zpclyn/GongXun2025/README.md

**更新日志**
|日期|发布人|内容|
| ---- | ---- | ---- |
|2026.10.27|zpclyn|根据各位的问询添加Tips并加入致谢|

</br>

# GongXun2025
**2025年工训赛智能物流河北省省冠开源**

PS：技术报告是直接Git推送的，.md文件直接在Github上查看可能有排版错误，建议使用Typora查看或者直接查看PDF文件。

---
### Tips:
1. 截至2026.10.27该智能物流小车在笔者见过的全部设计中依旧是最快的(**2分13秒**)成绩最高的(满分全一环)，与此同时成本也是最低的一批，笔者对此感到自豪。
2. 笔者全面开源的本意是新同学可以更快的上手，同时也可以给老队员提供一定的思路，推动整个智能物流圈子的发展，不过还是建议大家不要照搬全抄，这个设计还是有很多优化空间的。
3. 目前硬件部分的开源还做不到，涉及潘航同学的成果，除非潘航同学同意否则将无法提供硬件设计，不过笔者可以提供部分硬件设计方向，只是想要硬件设计的同学就不用加笔者联系方式了，真的提供不了。
4. 后面为了大家查看方便，或许会迁移Gitee。
5. **本开源未授权任何人借此商用，禁止任何人在未授权的情况下在任何平台售卖！**

---
## 致谢
该智能物流小车机械部分由**张展赫**同学为主笔者优化共同完成（前面写文档的时候真的真的忘记了，十分抱歉`(*>﹏<*)′），硬件和视觉部分由**潘航**同学([https://gitee.com/laladuduqq](https://gitee.com/laladuduqq))独立完成，控制部分由笔者独自完成。

然后感谢**刘浩**同学在第十届(2024)提供的大量大量帮助，感谢张坤同学和黄奕翀同学在第十一届(2025)提供的部分调试帮助。

其次感谢各位借鉴本开源的同学们，感谢各位对我的信任。据我所知今年河北赛区有多个队伍通过复刻本开源拿到省特等奖，笔者对此祝贺并感到欣喜。

最后提一嘴，设计没有高低适合自己适合比赛的才是最好的，不要无脑贬低，笔者不否认该设计从机械到控制并不绝对高级，但该设计简单适合比赛就是好设计，笔者接受合理的批评建议，但一边抄开源一边贬低就有点离谱了，最后希望各位使用开源分享在公共平台时可以提及本开源十分感谢`(*>﹏<*)′
