zpclyn/GongXun2025/IMAGE/屏幕截图 2025-11-13 145449.png

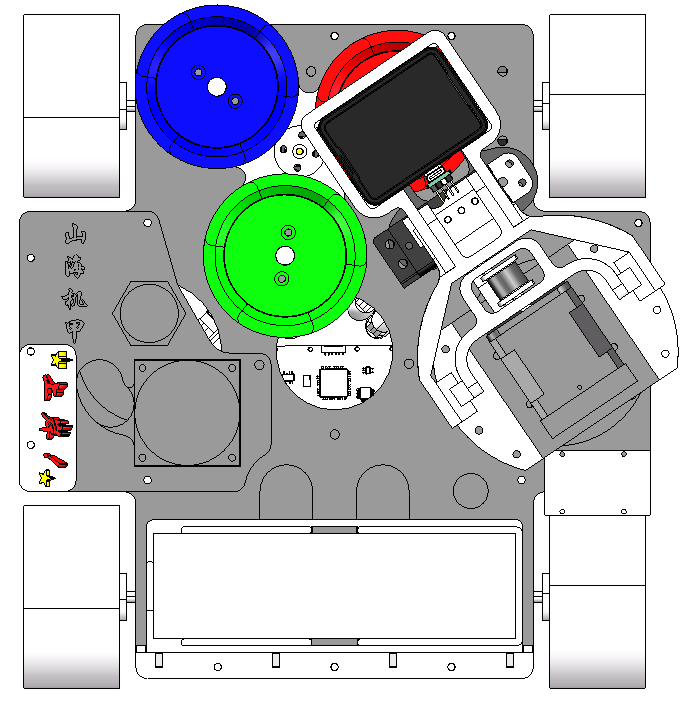
IMAGE/屏幕截图 2025-11-13 145449.png
