zpclyn/GongXun2025/机械/云台底板.SLDPRT

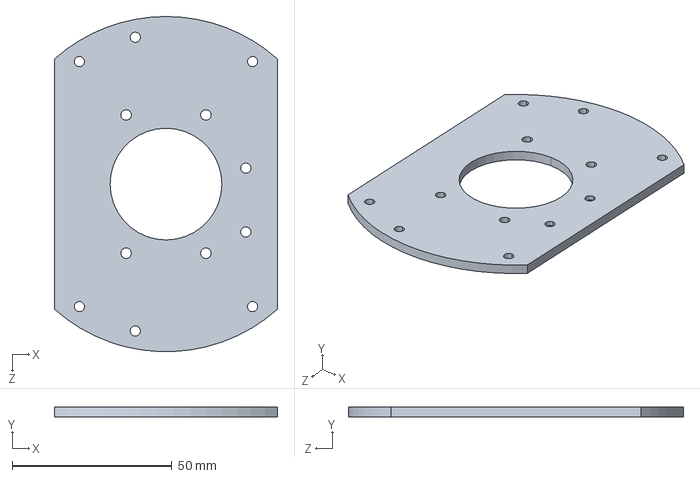
[picture p16: CAD file, 2025-11-13]
机械/云台底板.SLDPRT
70.0 x 3.00 x 104.9 mm
