zpclyn/GongXun2025/机械/云台轴承外挡边下板.SLDPRT

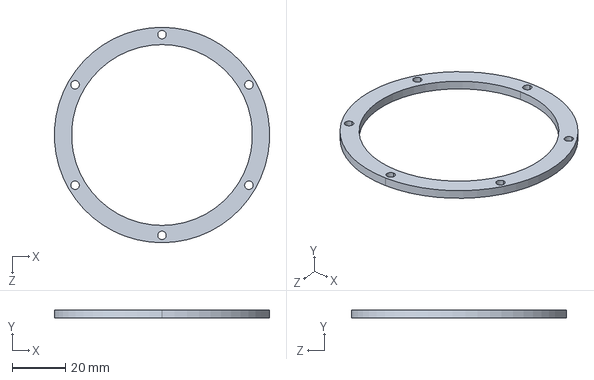
[picture p17: CAD file, 2025-11-13]
机械/云台轴承外挡边下板.SLDPRT
80.9 x 3.00 x 81.0 mm
