zpclyn/GongXun2025/机械/云台夹爪链接架.SLDPRT

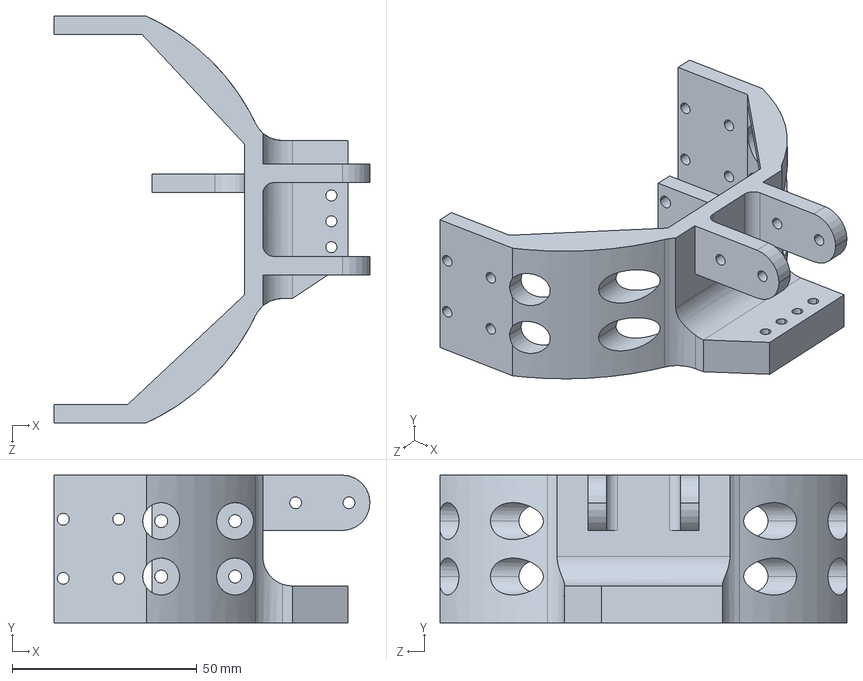
[picture p18: CAD file, 2025-11-13]
机械/云台夹爪链接架.SLDPRT
85.5 x 40.0 x 110.0 mm
