zpclyn/GongXun2025/机械/云台导轨连接块.SLDPRT

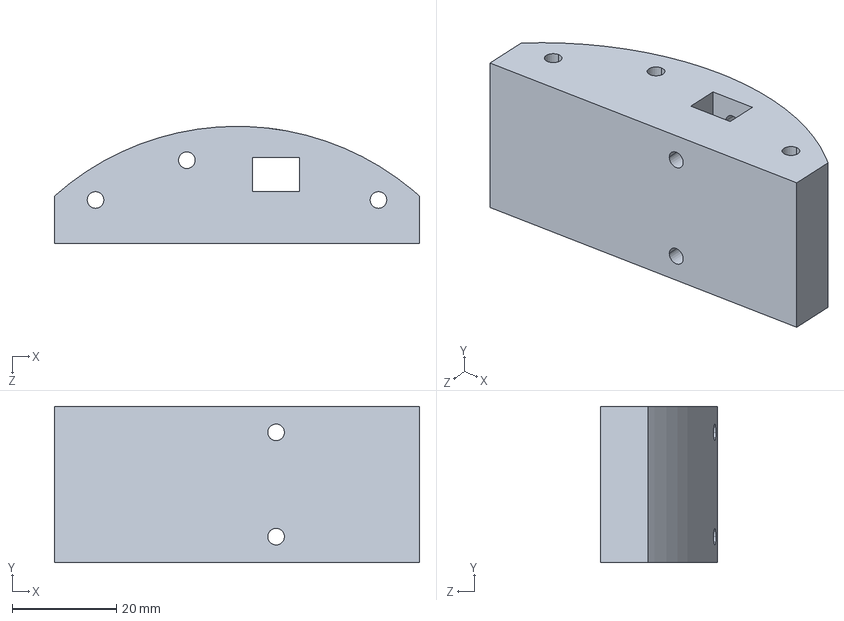
[picture p19: CAD file, 2025-11-13]
机械/云台导轨连接块.SLDPRT
70.0 x 30.0 x 22.5 mm
