zpclyn/GongXun2025/机械/导轨滑块.SLDPRT

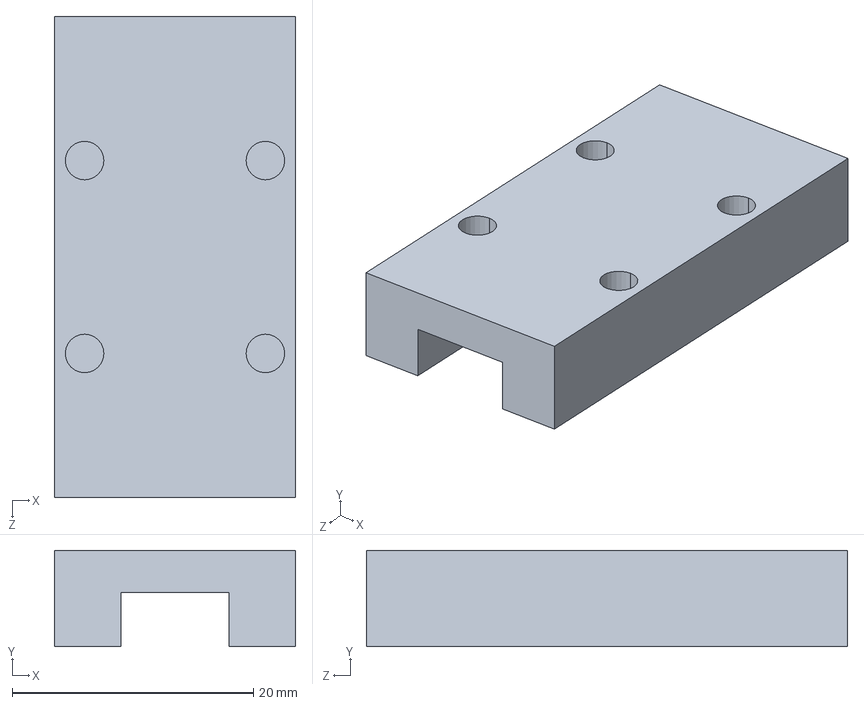
[picture p20: CAD file, 2025-11-13]
机械/导轨滑块.SLDPRT
20.0 x 8.00 x 39.9 mm
