zpclyn/GongXun2025/机械/云台轴承外挡边垫块.SLDPRT

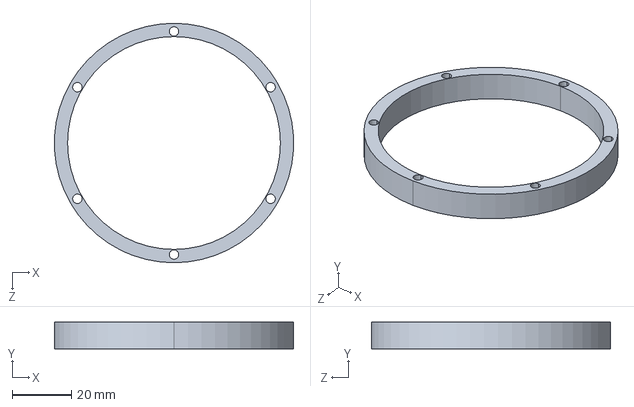
[picture p21: CAD file, 2025-11-13]
机械/云台轴承外挡边垫块.SLDPRT
80.9 x 9.00 x 81.0 mm
