zpclyn/GongXun2025/机械/推力轴承.SLDPRT

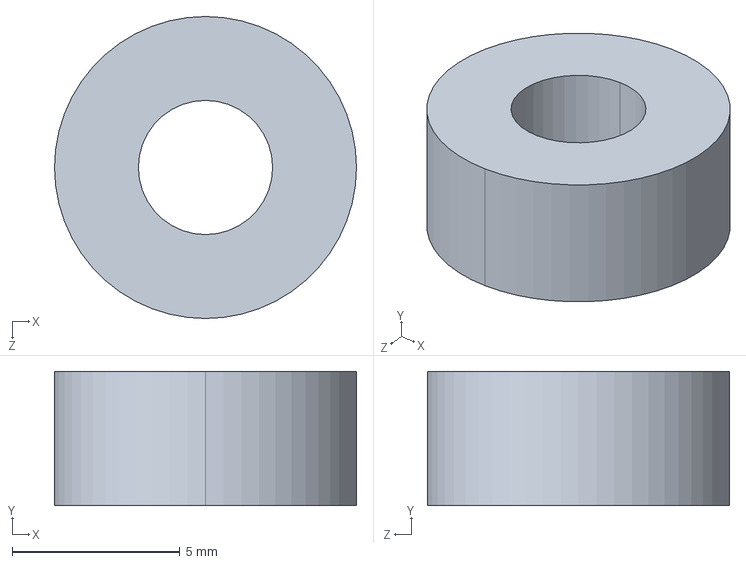
[picture p22: CAD file, 2025-11-13]
机械/推力轴承.SLDPRT
9.00 x 4.00 x 9.00 mm
