zpclyn/GongXun2025/机械/夹爪下层2.SLDPRT

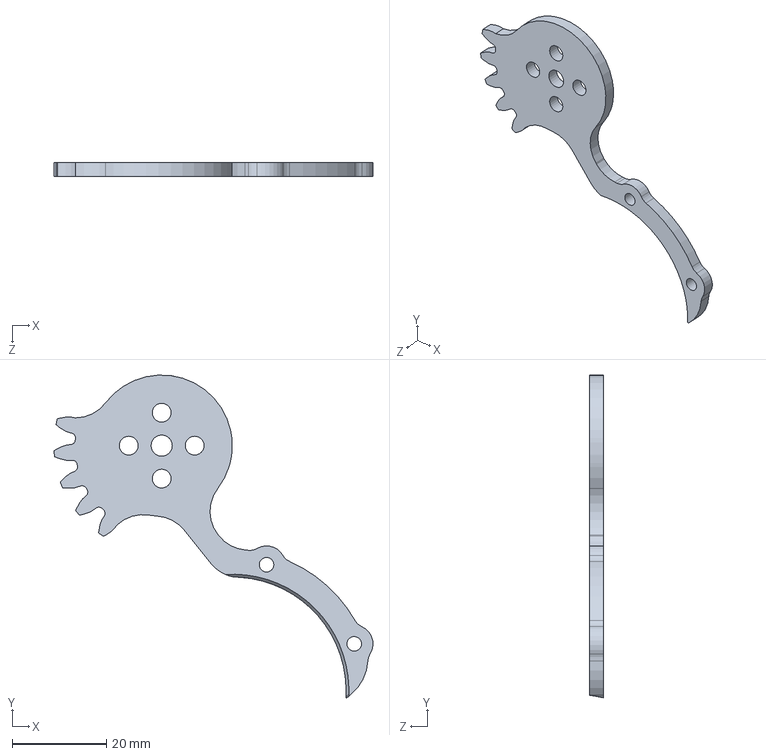
[picture p23: CAD file, 2025-11-13]
机械/夹爪下层2.SLDPRT
67.8 x 68.6 x 3.00 mm
