zpclyn/GongXun2025/机械/电池盒.SLDPRT

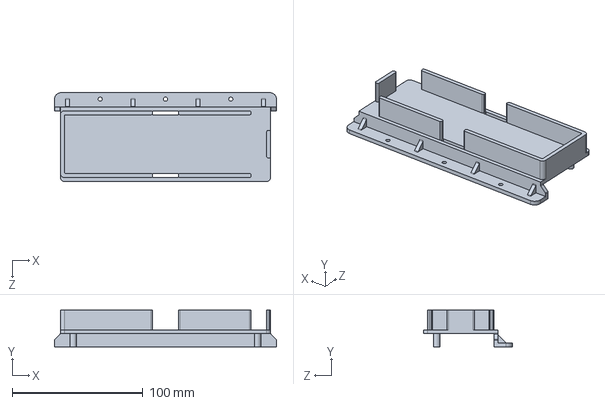
[picture p24: CAD file, 2025-11-13]
机械/电池盒.SLDPRT
170.0 x 28.0 x 68.0 mm
