zpclyn/GongXun2025/机械/上底板.SLDPRT

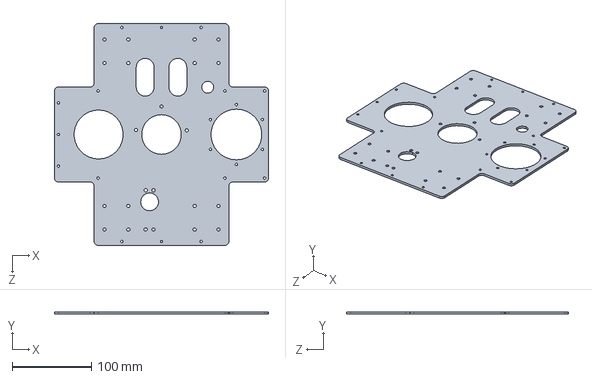
[picture p25: CAD file, 2025-11-13]
机械/上底板.SLDPRT
270.0 x 3.00 x 280.0 mm
