zpclyn/GongXun2025/机械/夹爪舵机架.SLDPRT

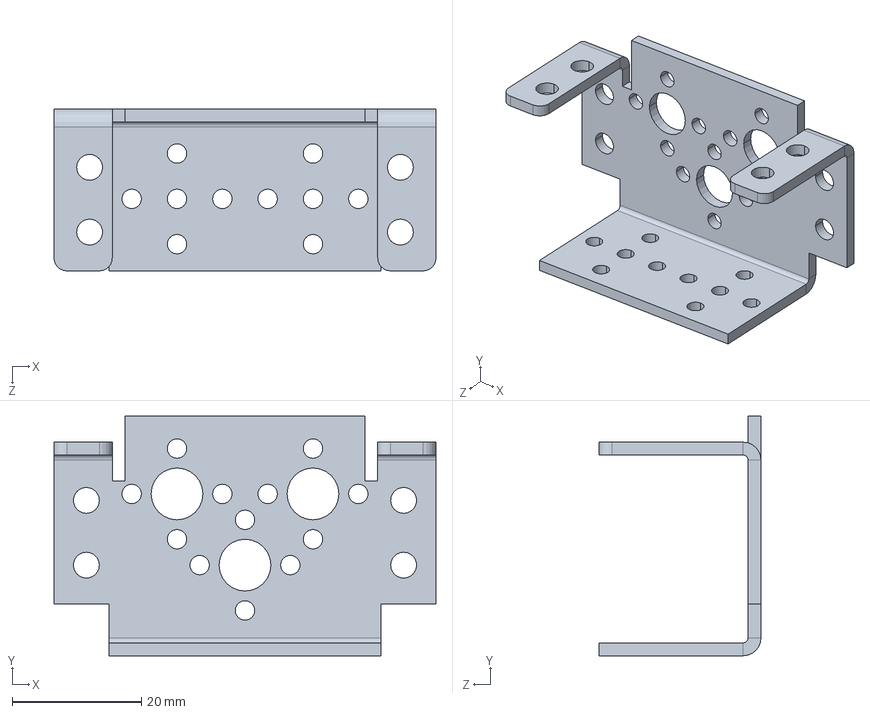
[picture p26: CAD file, 2025-11-13]
机械/夹爪舵机架.SLDPRT
59.0 x 37.0 x 25.0 mm
