zpclyn/GongXun2025/机械/六角不锈钢柱M3x45.SLDPRT

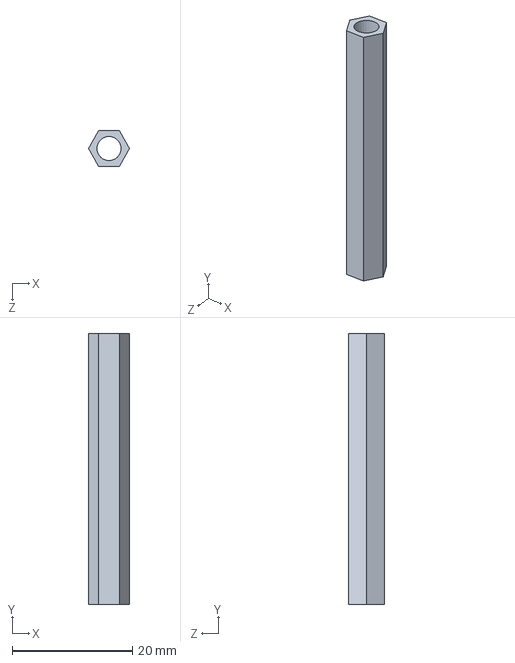
[picture p27: CAD file, 2025-11-13]
机械/六角不锈钢柱M3x45.SLDPRT
6.80 x 45.0 x 6.00 mm
