zpclyn/GongXun2025/机械/铝柱M4-D6-6.SLDPRT

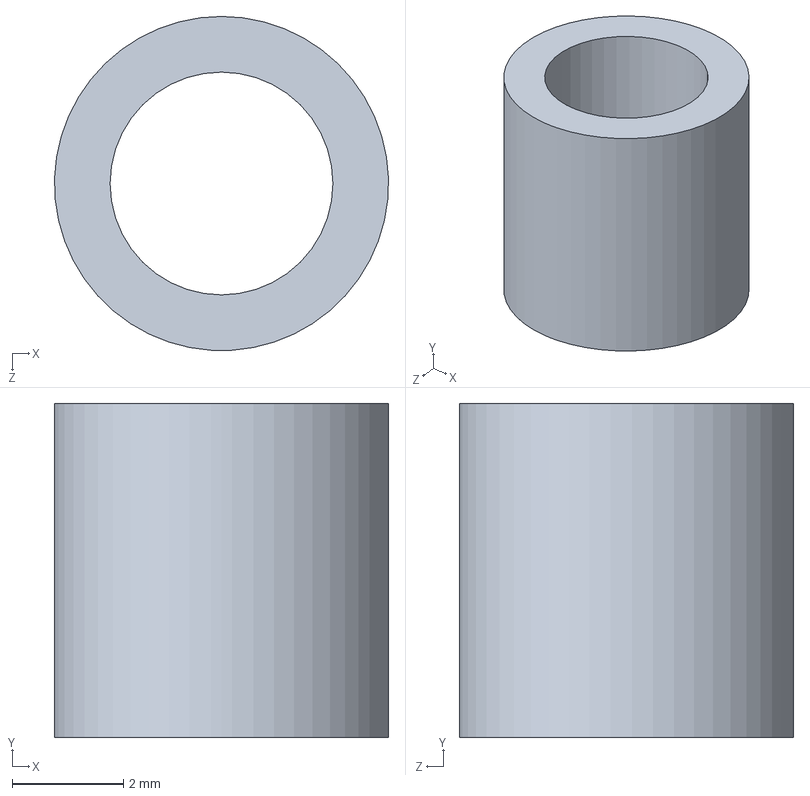
[picture p28: CAD file, 2025-11-13]
机械/铝柱M4-D6-6.SLDPRT
6.00 x 6.00 x 6.00 mm
