zpclyn/GongXun2025/机械/夹爪连接垫块.SLDPRT

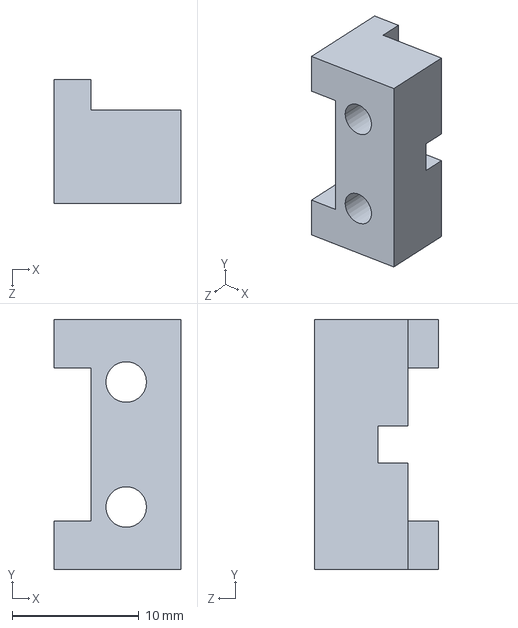
[picture p29: CAD file, 2025-11-13]
机械/夹爪连接垫块.SLDPRT
9.99 x 19.7 x 9.80 mm
