zpclyn/GongXun2025/机械/连接块6x6x40.SLDPRT

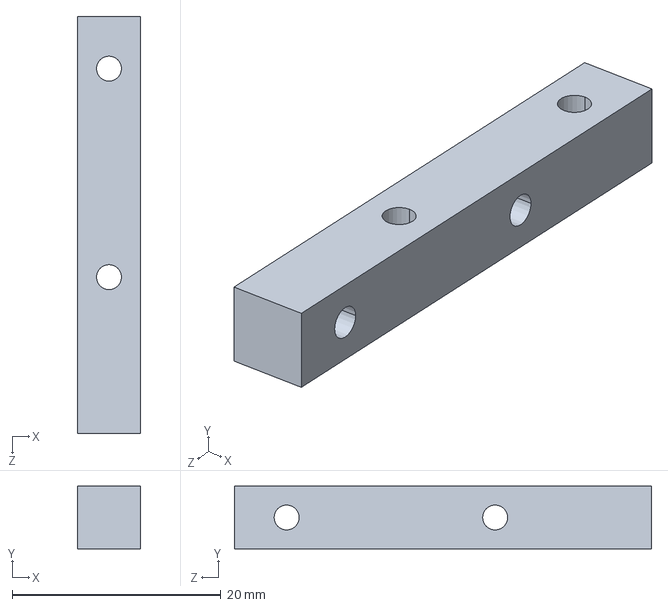
[picture p30: CAD file, 2025-11-13]
机械/连接块6x6x40.SLDPRT
6.00 x 6.00 x 40.0 mm
