zpclyn/GongXun2025/机械/舵盘.SLDPRT

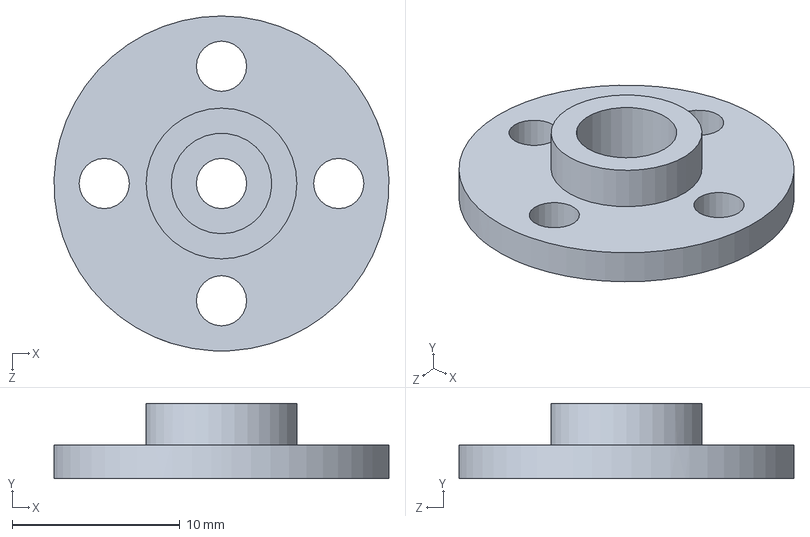
[picture p31: CAD file, 2025-11-13]
机械/舵盘.SLDPRT
20.0 x 4.50 x 20.0 mm
