zpclyn/GongXun2025/机械/摄像头固定件.SLDPRT

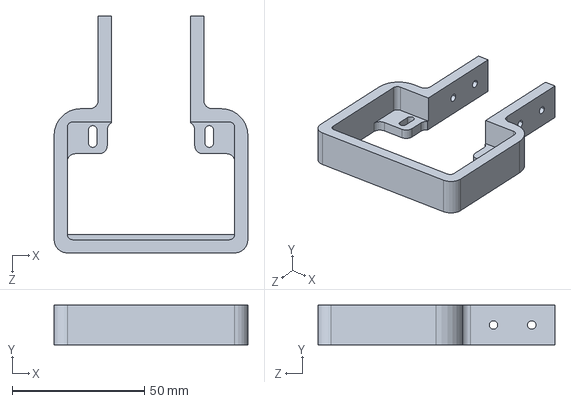
[picture p32: CAD file, 2025-11-13]
机械/摄像头固定件.SLDPRT
73.2 x 15.0 x 89.5 mm
