zpclyn/GongXun2025/机械/HWT101CT.SLDPRT

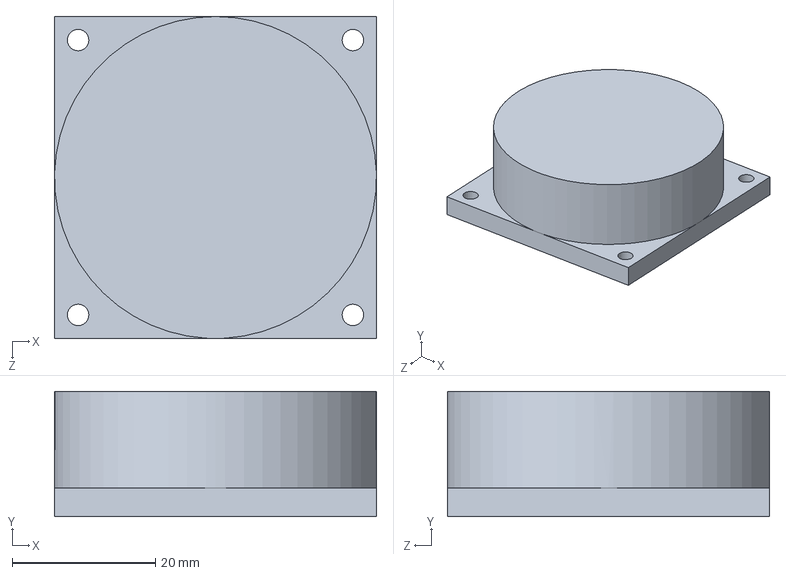
[picture p33: CAD file, 2025-11-13]
机械/HWT101CT.SLDPRT
45.0 x 17.5 x 45.0 mm
