zpclyn/GongXun2025/机械/电池.SLDPRT

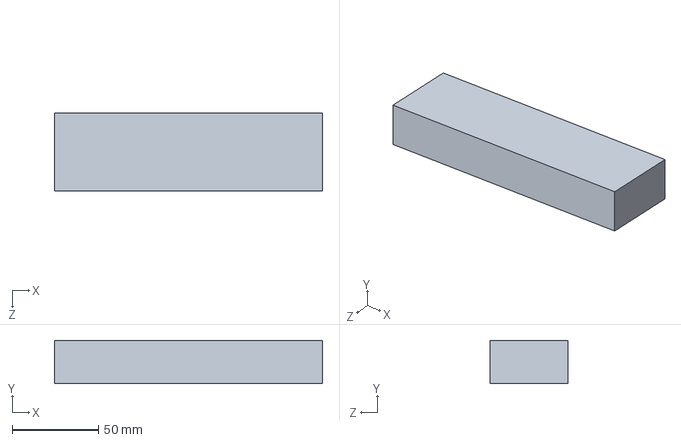
[picture p35: CAD file, 2025-11-13]
机械/电池.SLDPRT
155.0 x 25.0 x 45.0 mm
