zpclyn/GongXun2025/机械/初赛夹爪上层1-玻纤.SLDPRT

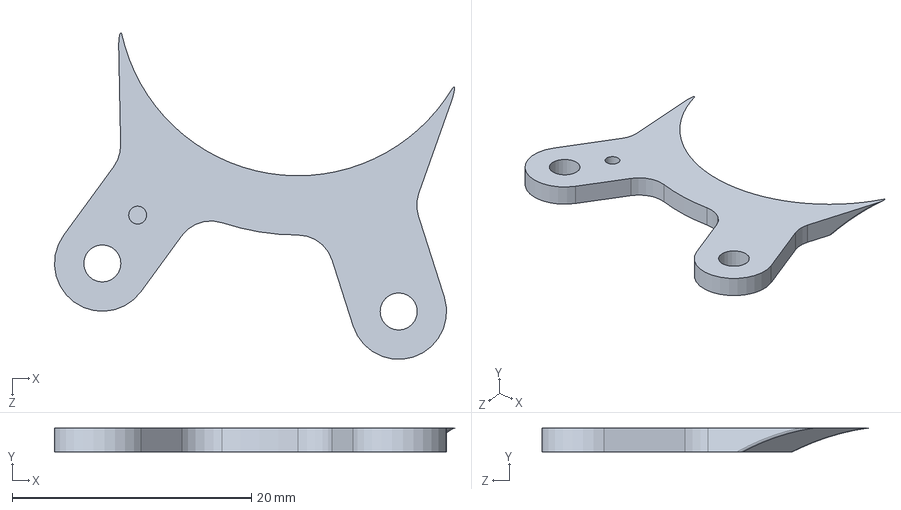
[picture p36: CAD file, 2025-11-13]
机械/初赛夹爪上层1-玻纤.SLDPRT
33.4 x 2.00 x 27.3 mm
