zpclyn/GongXun2025/机械/初赛物料.SLDPRT

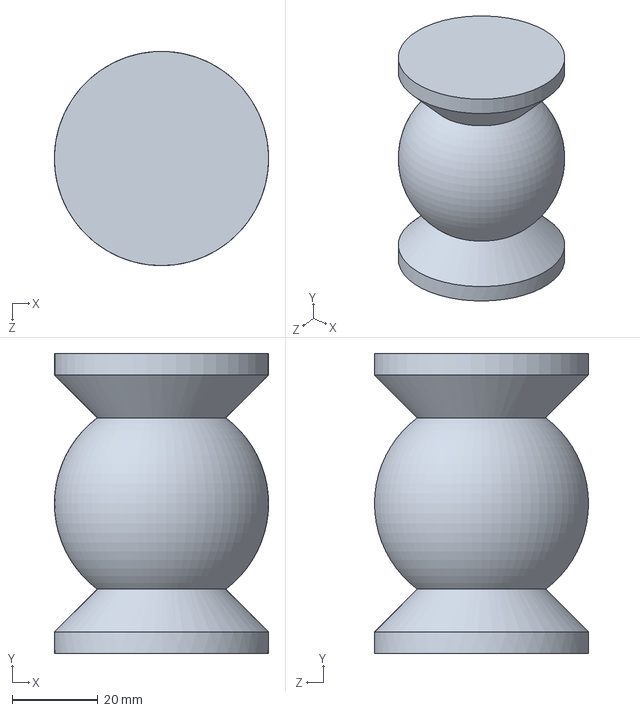
[picture p37: CAD file, 2025-11-13]
机械/初赛物料.SLDPRT
50.0 x 70.0 x 50.0 mm
