zpclyn/GongXun2025/机械/导轨250mm.SLDPRT

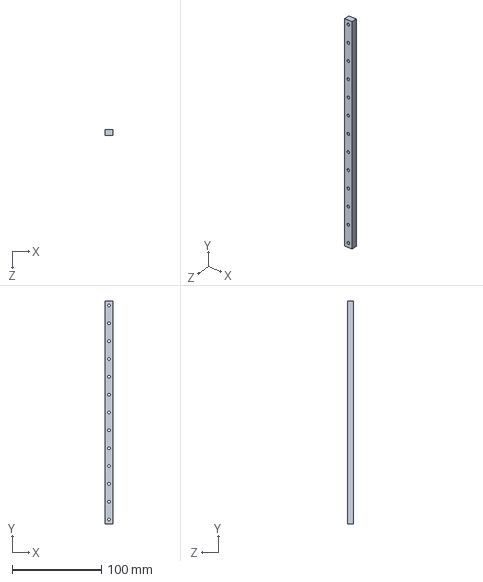
[picture p38: CAD file, 2025-11-13]
机械/导轨250mm.SLDPRT
9.00 x 250.0 x 6.50 mm
