zpclyn/GongXun2025/机械/上岸.SLDPRT

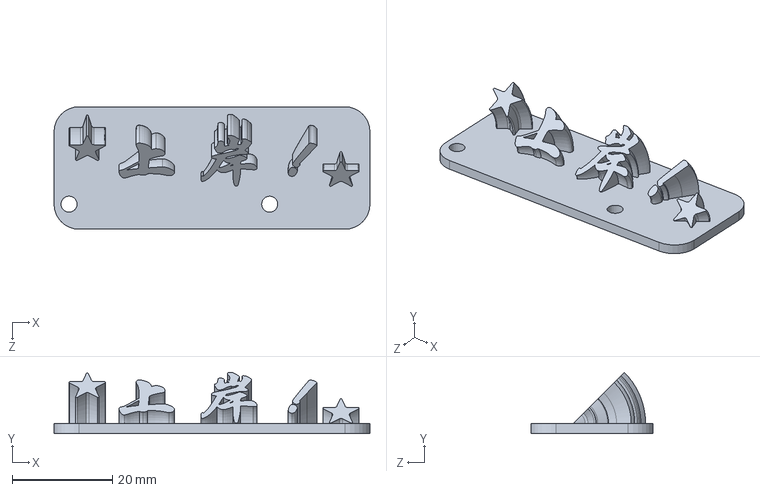
[picture p39: CAD file, 2025-11-13]
机械/上岸.SLDPRT
63.0 x 12.2 x 24.4 mm
