zpclyn/GongXun2025/机械/六角不锈钢柱M3x60.SLDPRT

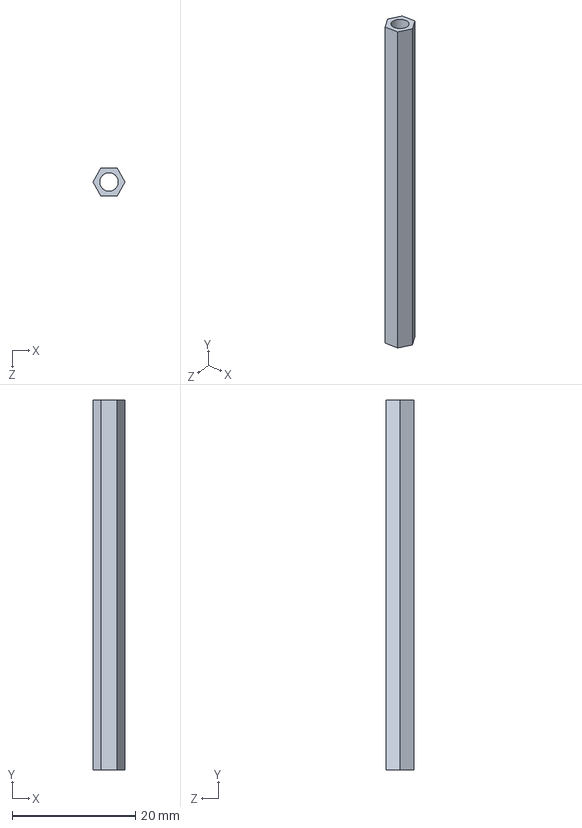
[picture p40: CAD file, 2025-11-13]
机械/六角不锈钢柱M3x60.SLDPRT
5.20 x 60.0 x 4.60 mm
