zpclyn/GongXun2025/机械/陀螺仪及按钮固定板.SLDPRT

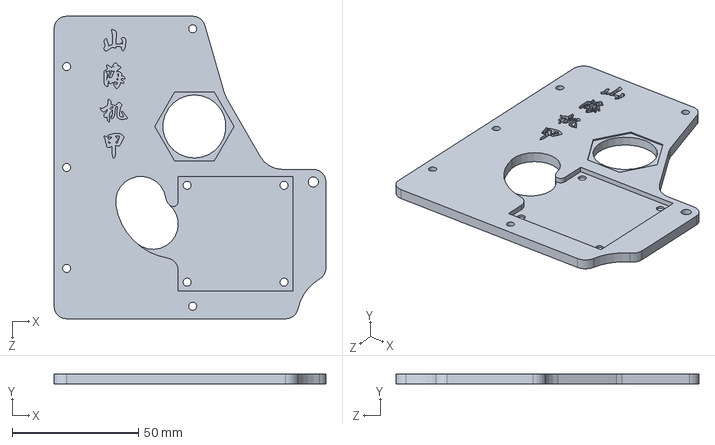
[picture p41: CAD file, 2025-11-13]
机械/陀螺仪及按钮固定板.SLDPRT
107.8 x 4.00 x 120.0 mm
