zpclyn/GongXun2025/机械/同步带压板.SLDPRT

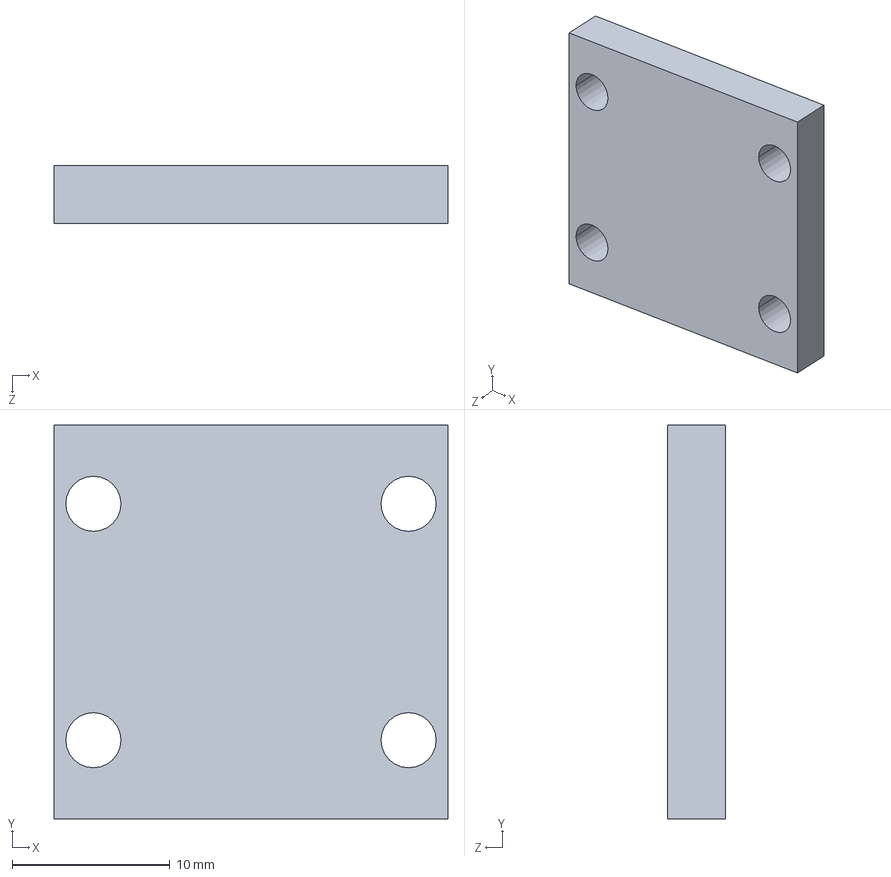
[picture p42: CAD file, 2025-11-13]
机械/同步带压板.SLDPRT
25.0 x 25.0 x 3.70 mm
