zpclyn/GongXun2025/机械/同步带轮上连接块.SLDPRT

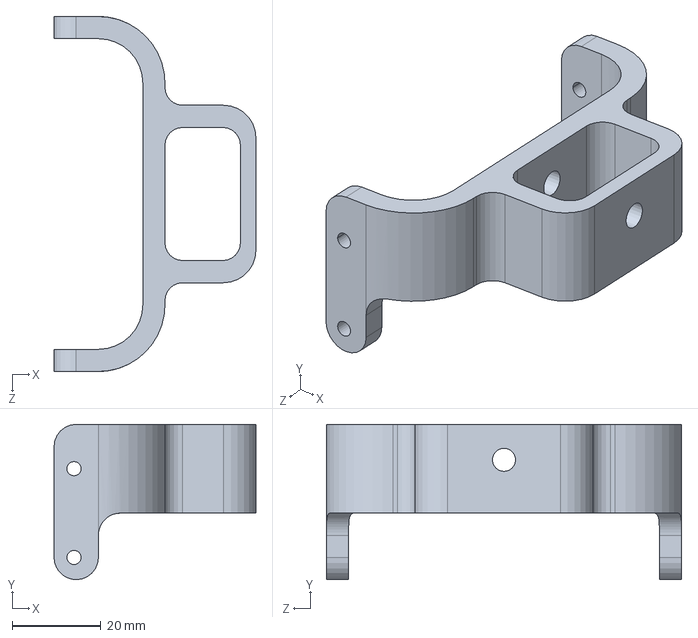
[picture p43: CAD file, 2025-11-13]
机械/同步带轮上连接块.SLDPRT
45.5 x 35.0 x 80.0 mm
