zpclyn/GongXun2025/机械/夹爪连接板.SLDPRT

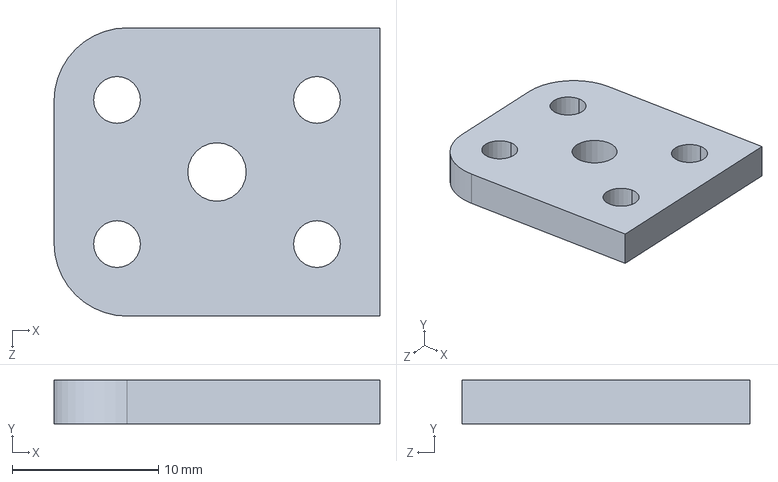
[picture p44: CAD file, 2025-11-13]
机械/夹爪连接板.SLDPRT
22.3 x 3.00 x 19.7 mm
