zpclyn/GongXun2025/机械/初赛物料座.SLDPRT

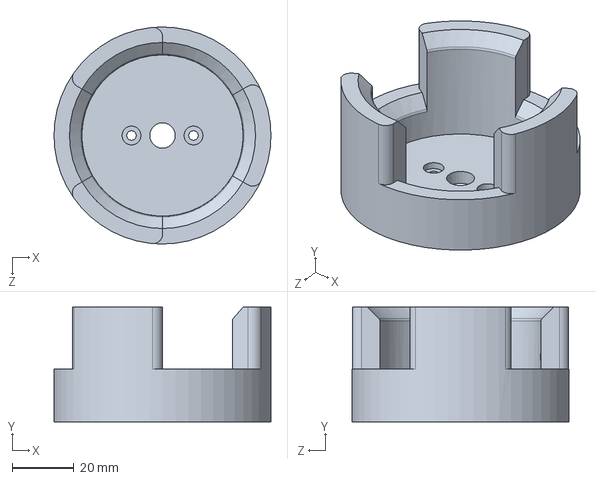
[picture p45: CAD file, 2025-11-13]
机械/初赛物料座.SLDPRT
70.0 x 37.0 x 70.0 mm
