zpclyn/GongXun2025/机械/决赛夹爪上层-CNC.SLDPRT

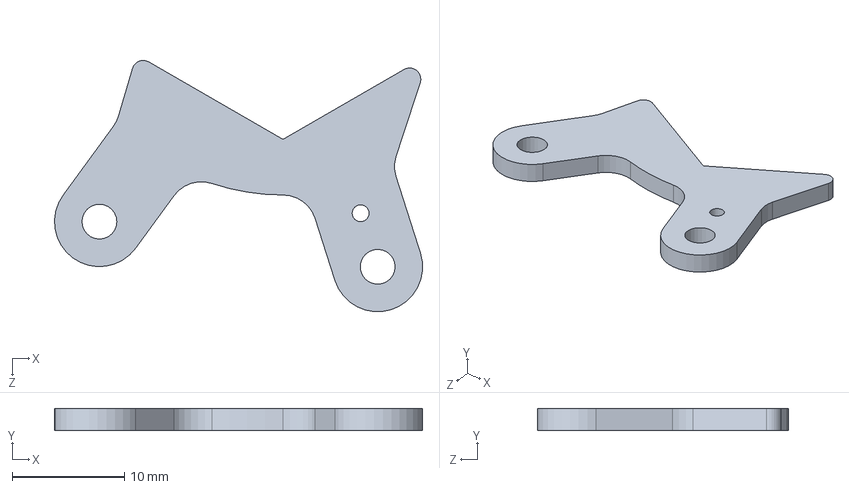
[picture p46: CAD file, 2025-11-13]
机械/决赛夹爪上层-CNC.SLDPRT
32.7 x 2.00 x 22.3 mm
