zpclyn/GongXun2025/机械/云台步进连接板.SLDPRT

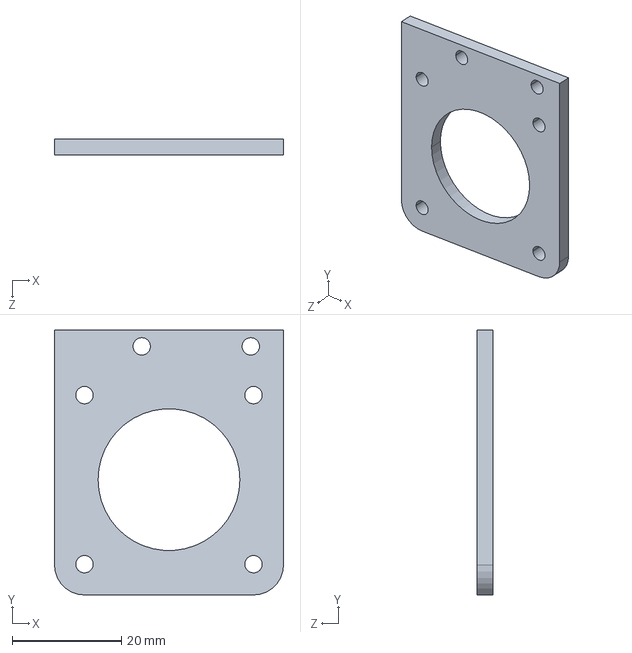
[picture p47: CAD file, 2025-11-13]
机械/云台步进连接板.SLDPRT
42.0 x 48.6 x 3.00 mm
