zpclyn/GongXun2025/机械/云台轴承内挡边下板.SLDPRT

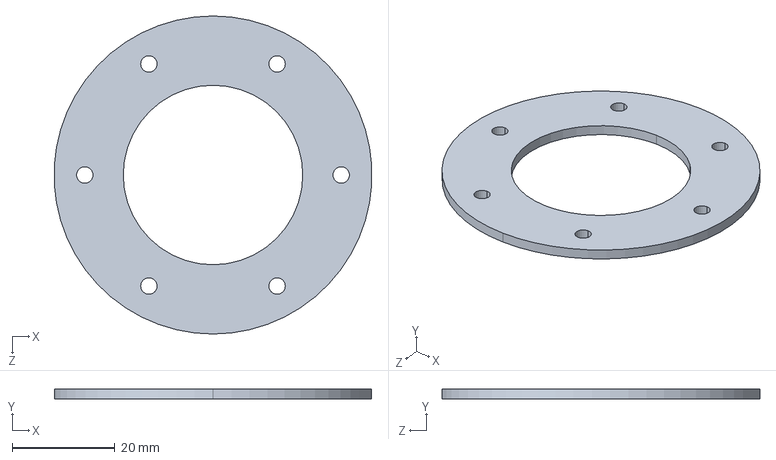
[picture p48: CAD file, 2025-11-13]
机械/云台轴承内挡边下板.SLDPRT
61.9 x 2.00 x 62.0 mm
