zpclyn/GongXun2025/机械/连接.SLDPRT

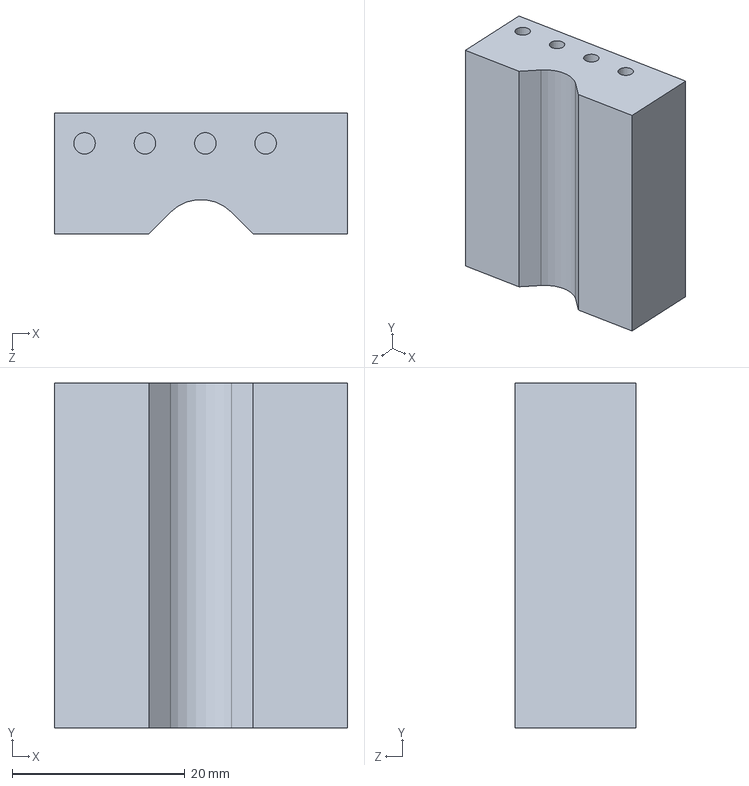
[picture p49: CAD file, 2025-11-13]
机械/连接.SLDPRT
34.0 x 40.0 x 14.0 mm
