zpclyn/GongXun2025/机械/云台轴承外挡边上板.SLDPRT

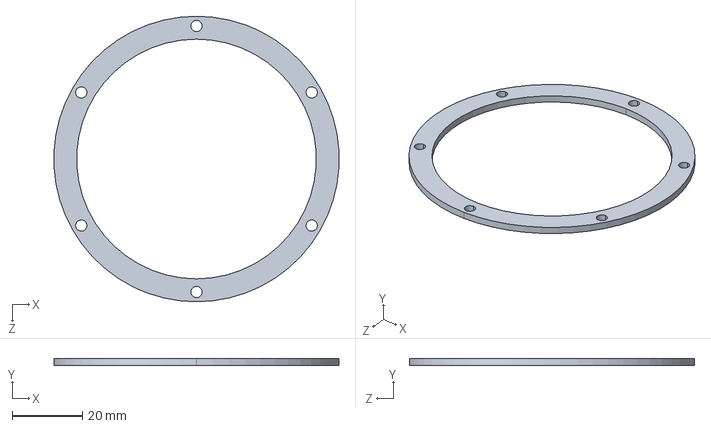
[picture p50: CAD file, 2025-11-13]
机械/云台轴承外挡边上板.SLDPRT
80.9 x 2.00 x 81.0 mm
