zpclyn/GongXun2025/机械/云台轴承内挡边.SLDPRT

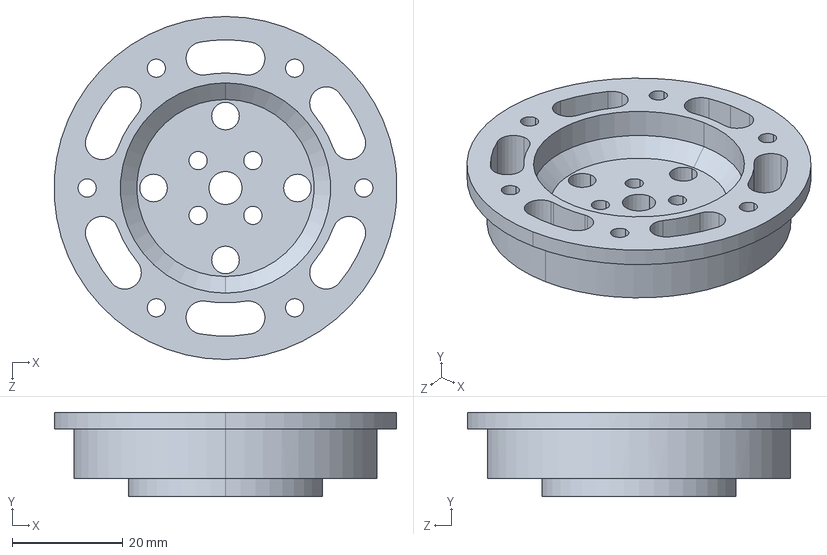
[picture p51: CAD file, 2025-11-13]
机械/云台轴承内挡边.SLDPRT
61.9 x 15.2 x 62.0 mm
