zpclyn/GongXun2025/机械/同步带.SLDPRT

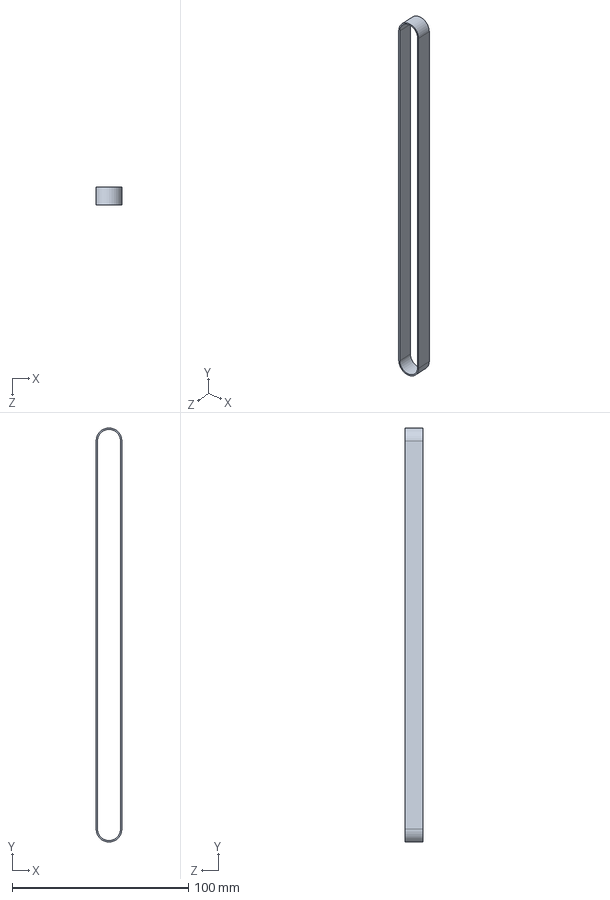
[picture p52: CAD file, 2025-11-13]
机械/同步带.SLDPRT
14.6 x 234.6 x 10.0 mm
