zpclyn/GongXun2025/机械/决赛物料顶层.SLDPRT

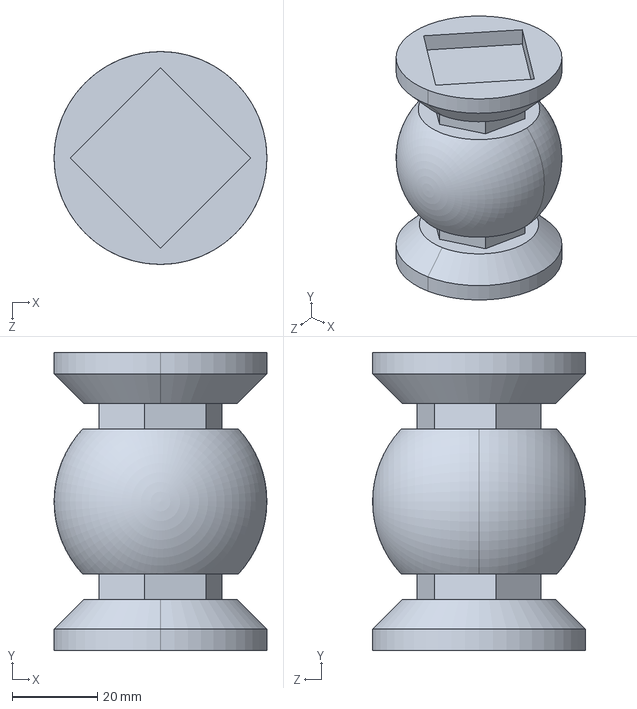
[picture p53: CAD file, 2025-11-13]
机械/决赛物料顶层.SLDPRT
50.0 x 70.0 x 50.0 mm
