zpclyn/GongXun2025/机械/42步进.SLDPRT

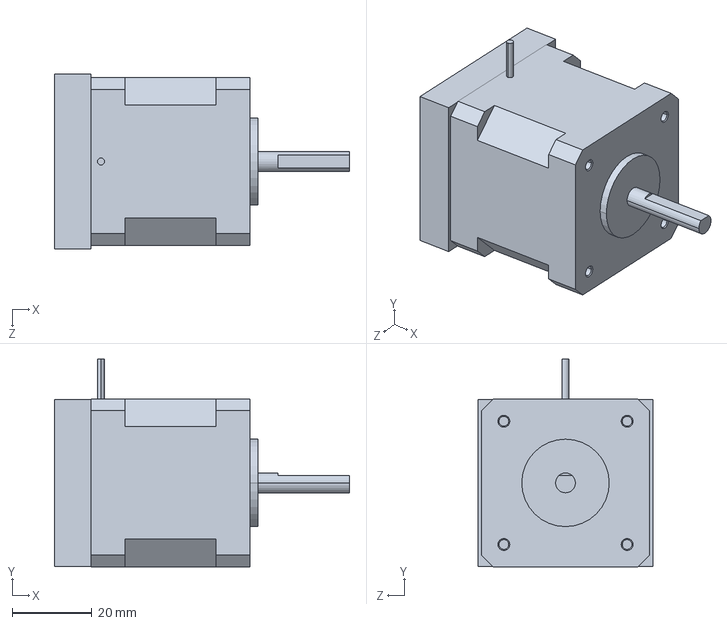
[picture p54: CAD file, 2025-11-13]
机械/42步进.SLDPRT
74.2 x 52.3 x 43.9 mm
