zpclyn/GongXun2025/机械/尼龙螺柱M3-D5-11.SLDPRT

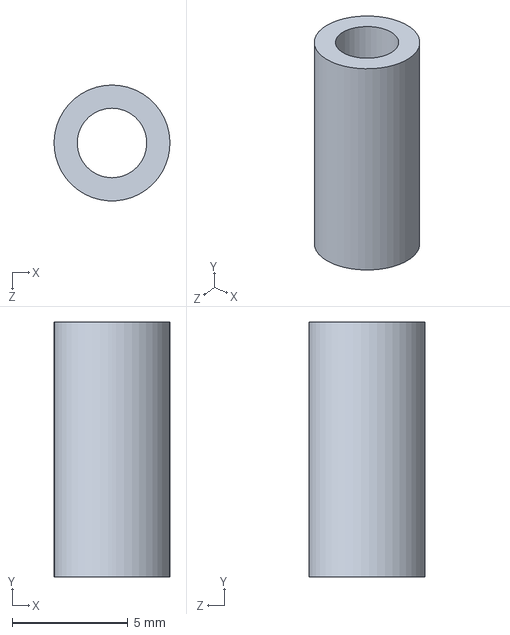
[picture p55: CAD file, 2025-11-13]
机械/尼龙螺柱M3-D5-11.SLDPRT
5.00 x 11.0 x 5.00 mm
