zpclyn/GongXun2025/机械/下底板.SLDPRT

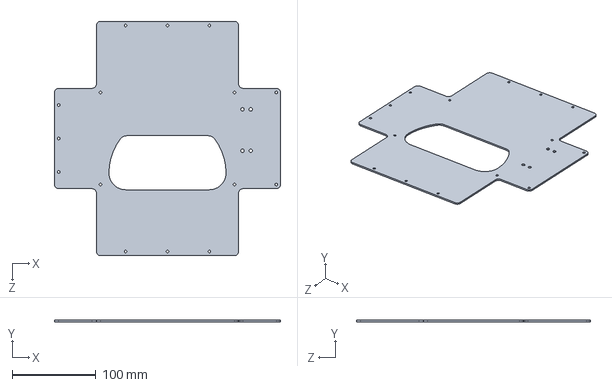
[picture p56: CAD file, 2025-11-13]
机械/下底板.SLDPRT
270.0 x 2.00 x 280.0 mm
