zpclyn/GongXun2025/机械/铝柱M4-D6-10.SLDPRT

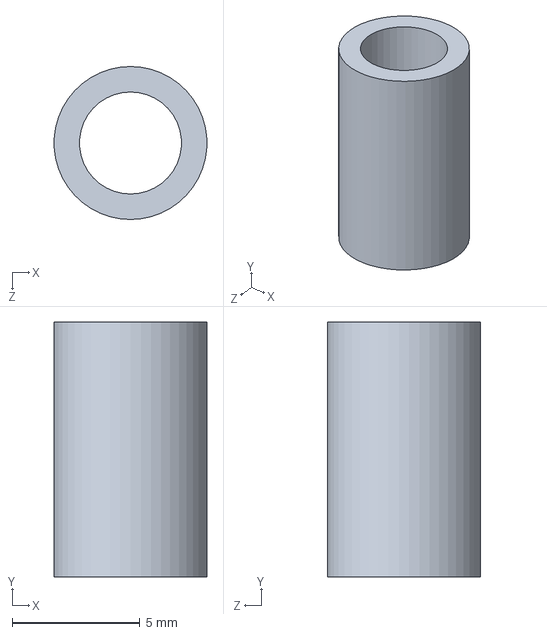
[picture p58: CAD file, 2025-11-13]
机械/铝柱M4-D6-10.SLDPRT
5.99 x 10.0 x 6.00 mm
