zpclyn/GongXun2025/机械/转盘.SLDPRT

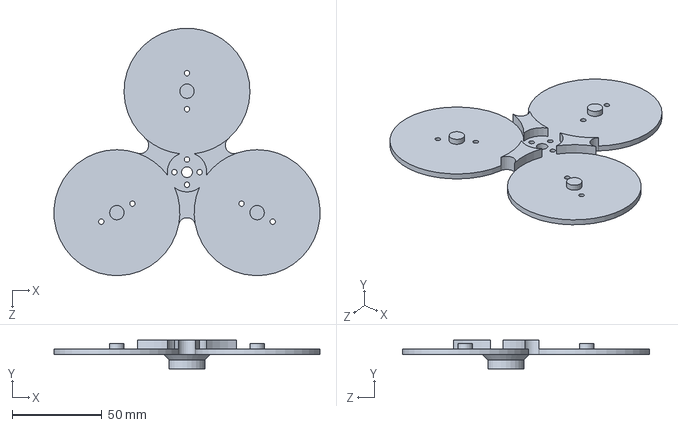
[picture p59: CAD file, 2025-11-13]
机械/转盘.SLDPRT
147.8 x 16.0 x 137.3 mm
