zpclyn/GongXun2025/机械/云台轴承.SLDPRT

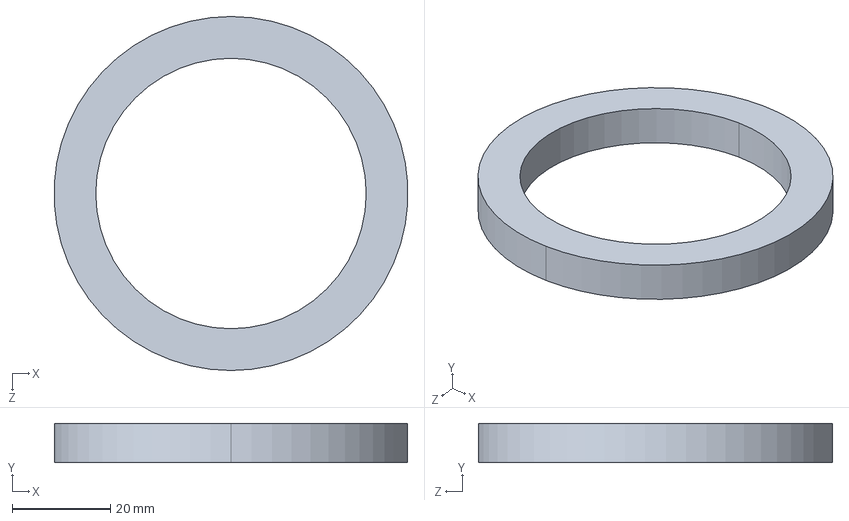
[picture p60: CAD file, 2025-11-13]
机械/云台轴承.SLDPRT
71.9 x 8.00 x 72.0 mm
