zpclyn/GongXun2025/机械/舵机.SLDPRT

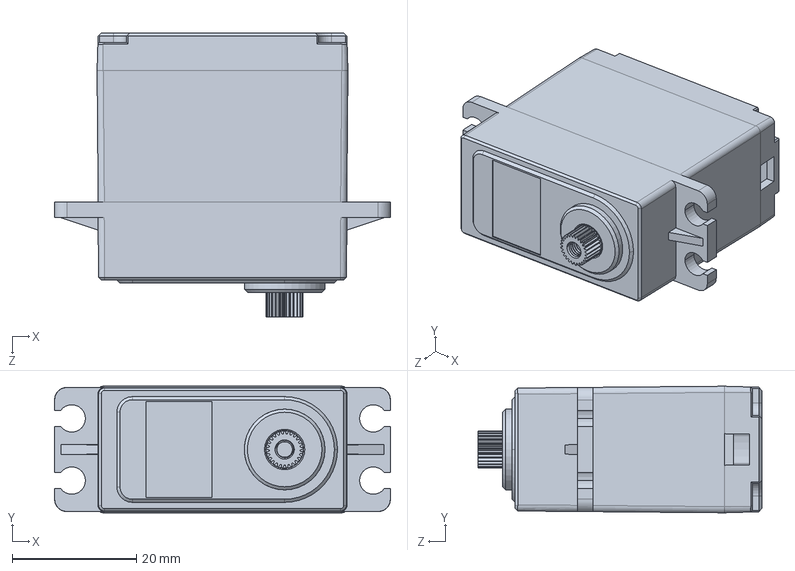
[picture p61: CAD file, 2025-11-13]
机械/舵机.SLDPRT
54.1 x 20.4 x 45.7 mm
