zpclyn/GongXun2025/机械/同步带轮.SLDPRT

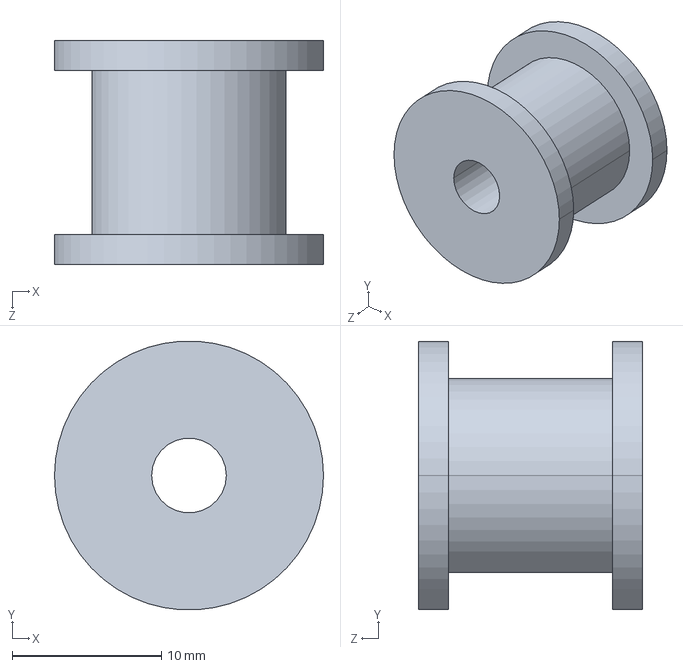
[picture p62: CAD file, 2025-11-13]
机械/同步带轮.SLDPRT
18.0 x 18.0 x 15.0 mm
