zpclyn/GongXun2025/机械/GM865二维码模块.SLDPRT

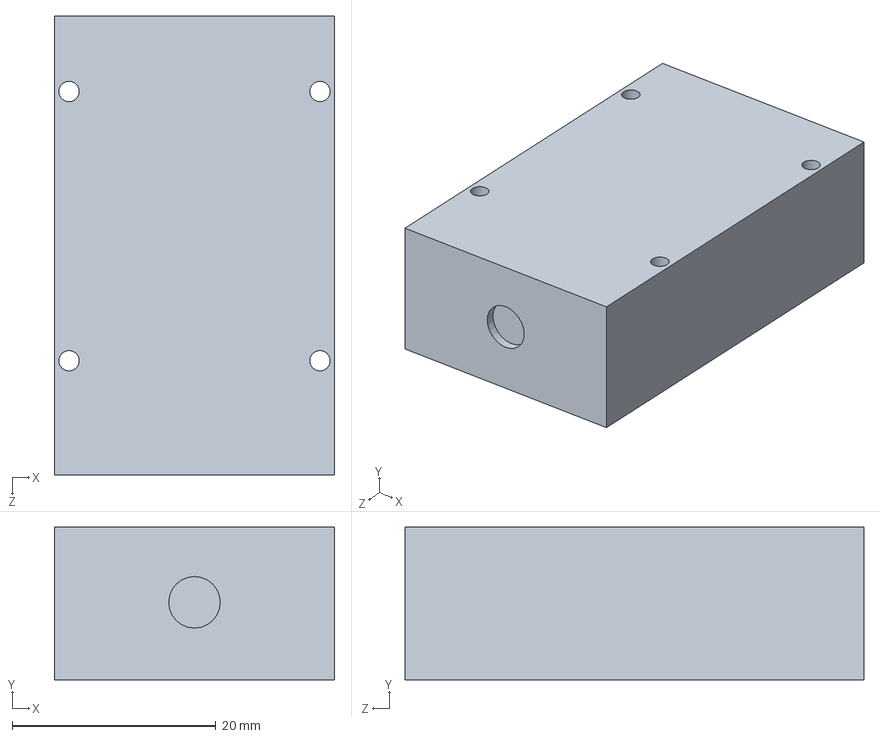
[picture p63: CAD file, 2025-11-13]
机械/GM865二维码模块.SLDPRT
27.5 x 15.0 x 45.0 mm
