zpclyn/GongXun2025/机械/夹爪下层1.SLDPRT

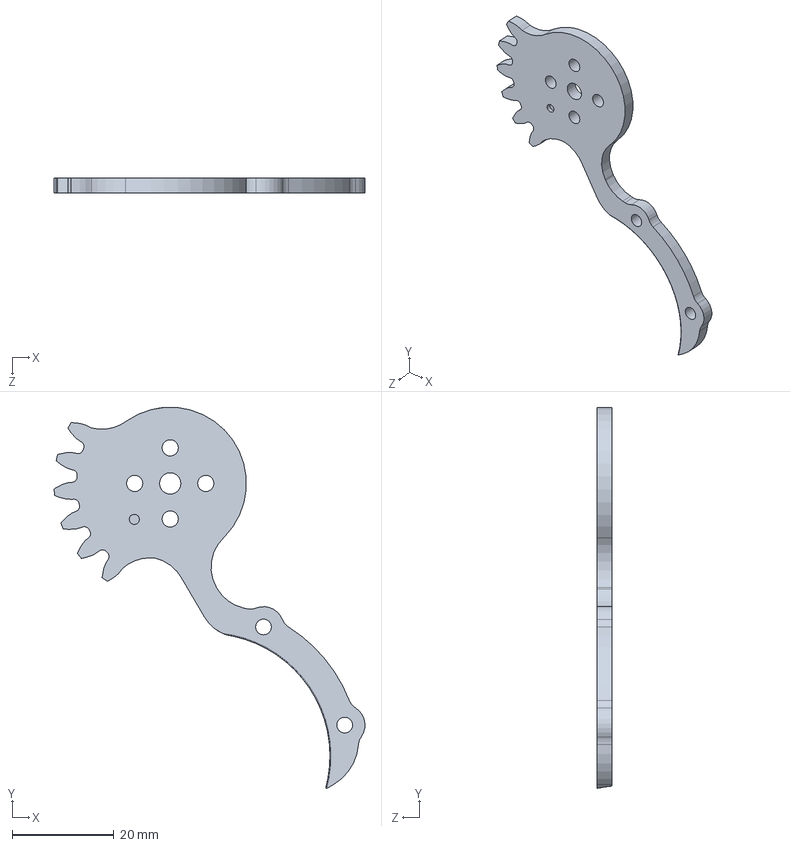
[picture p64: CAD file, 2025-11-13]
机械/夹爪下层1.SLDPRT
61.2 x 75.0 x 3.00 mm
