zpclyn/GongXun2025/机械/轮组.SLDASM

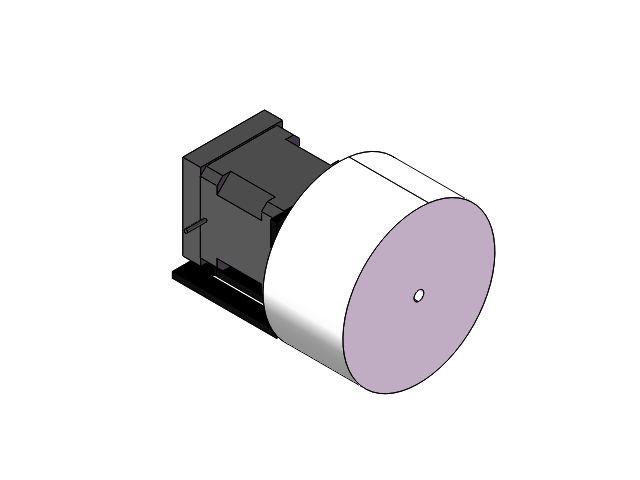
[picture p65: CAD file, 2025-11-13]
机械/轮组.SLDASM
42步进电机支架^是轮组_车(2)_车
llllll^是轮组_车(2)_车
42步进
