zpclyn/GongXun2025/(list of files, cad)

Other CAD files:
机械/初赛夹爪上层2-玻纤.SLDPRT
