zpclyn/GongXun2025/控制代码/Hardware/OLED_Font.h

#ifndef __OLED_FONT_H
#define __OLED_FONT_H

#include <stdint.h>

/*====================OLED任务码字模库,宽16像素,高64像素====================*/
const uint8_t OLED_TestNum[][16]=
{
	{0x00,0x00,0x00,0x00,0x80,0xE0,0xF8,0xFE,0xFE,0xFE,0x00,0x00,0x00,0x00,0x00,0x00},//1
	{0x00,0x00,0xFC,0xFF,0x7F,0x1F,0x0F,0xFF,0xFF,0xFF,0x00,0x00,0x00,0x00,0x00,0x00},
	{0x00,0x00,0x00,0x01,0x00,0x00,0x00,0xFF,0xFF,0xFF,0x00,0x00,0x00,0x00,0x00,0x00},
	{0x00,0x00,0x00,0x00,0x00,0x00,0x00,0xFF,0xFF,0xFF,0x00,0x00,0x00,0x00,0x00,0x00},
	{0x00,0x00,0x00,0x00,0x00,0x00,0x00,0xFF,0xFF,0xFF,0x00,0x00,0x00,0x00,0x00,0x00},
	{0x00,0x00,0x00,0x00,0x00,0x00,0x00,0xFF,0xFF,0xFF,0x00,0x00,0x00,0x00,0x00,0x00},
	{0x00,0x00,0x80,0x80,0x80,0x80,0x80,0xFF,0xFF,0xFF,0x80,0x80,0x80,0x80,0x00,0x00},
	{0x00,0x00,0x7F,0x7F,0x7F,0x7F,0x7F,0x7F,0x7F,0x7F,0x7F,0x7F,0x7F,0x7F,0x00,0x00},
	
	{0x00,0x00,0x80,0xE0,0xF8,0xFE,0xFE,0xFF,0xFF,0xFE,0xFC,0xF0,0x00,0x00,0x00,0x00},//2
	{0x00,0x00,0x03,0x3F,0x07,0x01,0x00,0x00,0x00,0x03,0x7F,0xFF,0xFF,0x00,0x00,0x00},
	{0x00,0x00,0x00,0x00,0x00,0x00,0x00,0x00,0x00,0x00,0x80,0xFF,0xFF,0x00,0x00,0x00},
	{0x00,0x00,0x00,0x00,0x00,0x00,0x00,0x00,0x00,0xC0,0xFF,0xFF,0x1F,0x00,0x00,0x00},
	{0x00,0x00,0x00,0x00,0x00,0x00,0x00,0xC0,0xFC,0xFF,0x3F,0x03,0x00,0x00,0x00,0x00},
	{0x00,0x00,0x00,0x00,0x00,0xF0,0xFE,0xFF,0x1F,0x01,0x00,0x00,0x00,0x00,0x00,0x00},
	{0x00,0x00,0xC0,0xF8,0xFF,0xBF,0x87,0x80,0x80,0x80,0x80,0x80,0x80,0x80,0x00,0x00},
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
	{0x00,0x80,0x80,0x80,0x80,0x80,0x80,0x00,0x00,0x05,0x05,0x05,0x05,0x05,0x05,0x00},//= 29
	{0x00,0x40,0x60,0xC0,0x80,0x00,0x00,0x00,0x00,0x00,0x18,0x0C,0x0D,0x07,0x03,0x00},//> 30
	{0x00,0x00,0x18,0x18,0x10,0xF0,0xE0,0x00,0x00,0x00,0x10,0x1B,0x19,0x01,0x00,0x00},//? 31
	{0x80,0xE0,0x30,0x98,0x88,0x98,0x70,0xE0,0x3F,0x7F,0xCF,0x9F,0x8E,0xDF,0x18,0x0F},//@ 32
	{0x00,0x00,0xE0,0xF0,0x70,0xF0,0x00,0x00,0x10,0x1F,0x07,0x04,0x04,0x07,0x1F,0x18},//A 33
	{0x00,0xF0,0xF0,0x10,0x10,0xF0,0xE0,0x00,0x00,0x1F,0x1F,0x11,0x11,0x1B,0x0F,0x06},//B 34
	{0x00,0xC0,0xE0,0x30,0x10,0x10,0x30,0x00,0x00,0x0F,0x1F,0x18,0x10,0x10,0x18,0x00},//C 35
	{0x00,0xF0,0x10,0x10,0x30,0x30,0xE0,0xC0,0x00,0x1F,0x10,0x10,0x18,0x1C,0x0F,0x07},//D 36
	{0x00,0xF0,0xF0,0x10,0x10,0x10,0x10,0x00,0x00,0x1F,0x1F,0x11,0x11,0x11,0x11,0x00},//E 37
	{0x00,0xF0,0xF0,0x10,0x10,0x10,0x10,0x00,0x00,0x1F,0x1F,0x01,0x01,0x01,0x01,0x00},//F 38
	{0x80,0xE0,0x70,0x30,0x10,0x10,0x30,0x30,0x03,0x0F,0x1C,0x18,0x11,0x11,0x1F,0x1F},//G 39
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
};

#endif
