zpclyn/GongXun2025/控制代码/User/isr.h

#ifndef __ISR_H
#define __ISR_H

#include "Arm.h"						//爪臂机构
#include "Camera.h"						//摄像头
#include "HWT101.h"						//陀螺仪
#include "Key.h"						//按键
#include "QR.h"							//二维码模块
#include "StepMotor.h"					//步进

#endif
