zpclyn/GongXun2025/(commit log)

2025-11-13 上传项目全部信息
    [42步进.SLDPRT, GM865二维码模块.SLDPRT, HWT101CT.SLDPRT, 上岸.SLDPRT, 上底板.SLDPRT, 下底板.SLDPRT, 云台夹爪链接架.SLDPRT, 云台导轨连接块.SLDPRT]
2025-11-13 上传项目文件
2026-10-27 更新Tips和致谢
    Added update log, tips, and acknowledgments to README.
2026-10-27 更新Tips和致谢
    Updated acknowledgments for the 2024 and 2025 events.
